wrcrooks/5U-19in-DAS-Chassis/README.md

# 5U 19-inch DAS Chassis

A 5U rack-mount direct-attached storage chassis for 48 3.5-inch drives, designed to be cooled by quiet
120 mm fans. The sheet-metal parts are laid out for laser cutting and bending by
[SendCutSend](https://sendcutsend.com/) in 0.080 in (2.032 mm) 5052-H32 aluminium; the handles and
backplane trays are 3D printed.

**Status: design in progress. Nothing here has been manufactured or thermally tested yet.** See
[Open items](#open-items) before ordering parts.

## Design summary

| | |
|---|---|
| Drives | 48 x 3.5 in, in 16 stacks of three, broad faces parallel to the airflow |
| Backplanes | 4 x Supermicro BPN-SAS3-826EL1 / BPN-SAS3-826EL1-N4 (same hole pattern), on printed trays at 105.4 mm pitch |
| SAS expanders | 2 x Adaptec AEC-82885T (36-port, 12 Gb/s) in the Back Panel card slots, external SFF-8644 to the host, powered by 4-pin Molex |
| Fans | 3 x 120 mm in the Bezel and 3 x 120 mm in the fan wall behind the drives |
| Envelope | 430 mm wide (436 mm over the cover flanges), 738 mm deep, 221 mm (5U) at the Bezel |
| Airflow | Front to back: Bezel, drive array, fan wall, rear electronics, Back Panel exhaust |
| Covers | Two drop-in lids (drive bay and rear electronics), no fasteners, finger holes for lifting |

The backplanes are spread apart rather than mounted edge to edge. That leaves 25 mm of air between drive
stacks, which keeps the pressure drop through the array low enough for quiet fans.

## Repository layout

```
CAD/
  Assembly - *.step        Original Onshape export, one part per file (reference, not edited)
  Complete-Assembly/       Original Onshape assembly
  Backplane Tray/          Printed backplane tray parts (original)
  Revised/                 Manufacturable parts and assembly, generated by tools/rebuild_parts.py
  Flat-Patterns/           DXF flat patterns, bend-data.json and Bend-Data.md
tools/
  sheetmetal.py            Unfolding, re-thickening and DXF writing
  rebuild_parts.py         Builds CAD/Revised/ from the Onshape export
  unfold_sheet_metal.py    Builds CAD/Flat-Patterns/ from CAD/Revised/
```

[`CAD/Flat-Patterns/Bend-Data.md`](CAD/Flat-Patterns/Bend-Data.md) is the main design document. It lists
every change from the Onshape export and the reason for it, the material and bend parameters, a bend
table per part, and the checks against SendCutSend's design rules.

[`BOM.md`](BOM.md) is the bill of materials with a cost estimate for one build.

## Parts

**Sheet metal** (STEP in `CAD/Revised/`, DXF in `CAD/Flat-Patterns/`):

| Part | Qty | Bends |
|---|---|---|
| Chassis | 1 | 2 |
| Bezel | 1 | 0 |
| Back Panel | 1 | 2 |
| Chassis Rear Support Bracket (fan wall) | 1 | 2 |
| Drive Support Panel | 1 | 2 |
| Bezel Mounting Bracket | 2 | 1 |
| Drive Bay Cover | 1 | 2 |
| Rear Electronics Cover | 1 | 2 |
| Attic Baffle | 2 | 2 |

**3D printed:**

| Part | Qty | Source |
|---|---|---|
| Left / Right Front Handle (ABS) | 1 each | `CAD/Assembly - * Front Handle.step` |
| Backplane Tray, Part A and Part B | 4 each | `CAD/Backplane Tray/` |
| Backplane Tray Connector (joins Part A to Part B) | 8 | `CAD/Backplane Tray/` |
| Backplane Tray Connector (Wide) (joins neighbouring trays) | 12 | `CAD/Revised/` |
| Backplane Tray Air Dam | 4 | `CAD/Revised/` |
| Card Edge Support | 1 | `CAD/Revised/` |

The SFF8643 to M.2 Mounting Bracket is exported as designed in Onshape; how it will be made is undecided.

## Regenerating the outputs

Requires [FreeCAD](https://www.freecad.org/) 0.20 or later (developed against 0.20.2). No other
dependencies. From the repository root:

```sh
freecadcmd tools/rebuild_parts.py       # CAD/*.step -> CAD/Revised/
freecadcmd tools/unfold_sheet_metal.py  # CAD/Revised/ -> CAD/Flat-Patterns/
```

Run both, in that order, after any change. Dimensions of the new and modified parts are constants at
the top of `tools/rebuild_parts.py`; material and bend parameters are in `MATERIAL` in
`tools/sheetmetal.py`. Both scripts check their own results (valid solids, closed contours, cut-out
counts, interference between parts) and print the findings.

## DXF conventions

Millimetres at 1:1, everything on layer `0`. Cut geometry is continuous; bend centrelines are `DASHED`.
Each pattern is drawn looking at the face the flanges fold toward, so every bend is 90° up.

## Open items

- **Thermal performance is estimated by hand, not simulated or measured.** Test one fully populated
  backplane with the intended fans before committing to the full build.
- **Fan-wall cable cut-outs** are larger than the cables need and let air recirculate. They need to be
  sized to the real cable bundles or closed with brush strip or foam.
- **Drive position on the backplane** is taken from the tray model, not measured on a real board. Check
  the Drive Support Panel openings against a populated backplane before cutting.
- **Card Edge Support position is estimated.** The sideways position of the card PCBs is worked out from
  the Back Panel openings, not measured on a card. The support's slotted holes give ±4 mm; check the fit
  with a card in hand before drilling or ordering the Chassis.
- **Empty drive positions** need printed blanks, or air will bypass the populated ones.
- **Dust:** fit screw-on filters to the Bezel fan positions. The Bezel is aluminium, so magnetic filters
  will not hold.
- **Covers are held by gravity only** and need securing for transport.
- The Back Panel has one 1.35 mm strip between cut-outs, carried over from the original model.

## License

[CC0 1.0 Universal](LICENSE). The design files, flat patterns, scripts and documentation are dedicated to
the public domain: anyone may copy, modify, manufacture, sell and redistribute them for any purpose,
without asking permission or giving credit. They are provided as-is, with no warranty.
