wrcrooks/5U-19in-DAS-Chassis/CAD/Assembly - SFF8643 to M.2 Mounting Bracket.step

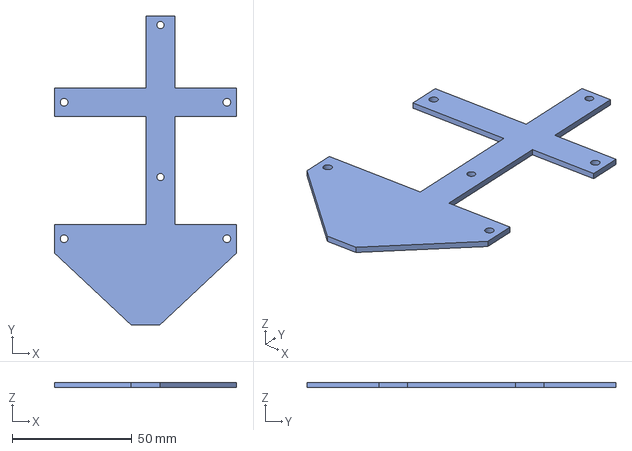
[picture p1: CAD file, 2026-11-12]
CAD/Assembly - SFF8643 to M.2 Mounting Bracket.step
76.0 x 129.0 x 2.00 mm
