wrcrooks/5U-19in-DAS-Chassis/CAD/Complete-Assembly/Complete-Assembly.step

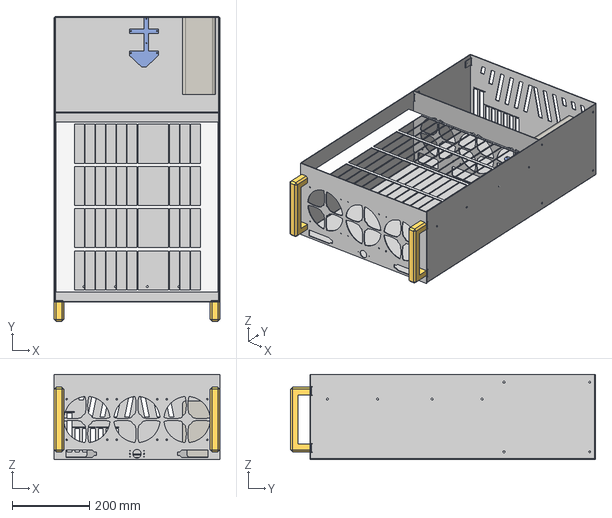
[picture p2: CAD file, 2026-11-12]
CAD/Complete-Assembly/Complete-Assembly.step
430.0 x 792.0 x 221.0 mm
