wrcrooks/5U-19in-DAS-Chassis/CAD/Assembly - Drive Support Panel.step

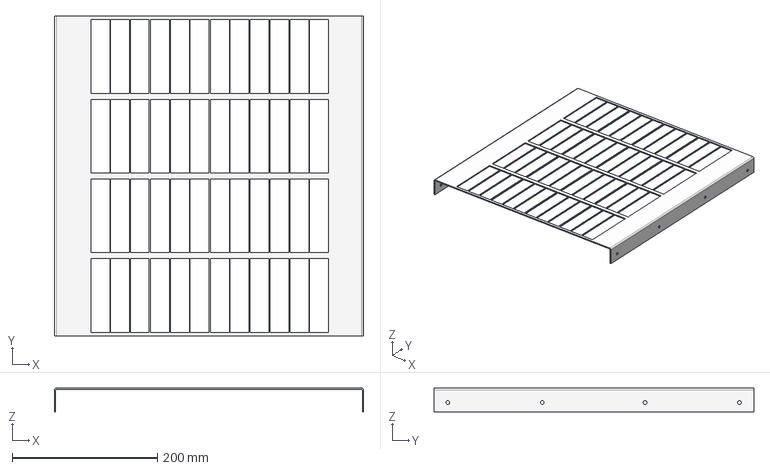
[picture p3: CAD file, 2026-11-12]
CAD/Assembly - Drive Support Panel.step
426.0 x 440.5 x 33.0 mm
