wrcrooks/5U-19in-DAS-Chassis/CAD/Revised/Complete-Assembly.step

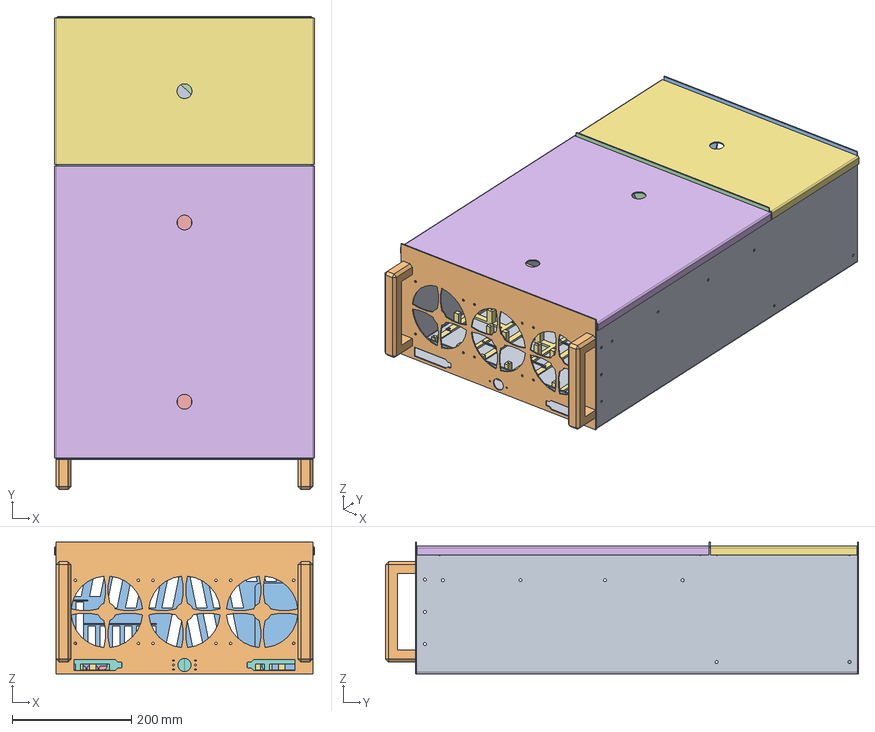
[picture p4: CAD file, 2026-11-13]
CAD/Revised/Complete-Assembly.step
436.1 x 792.1 x 221.0 mm
Chassis
Bezel
Back Panel
Chassis Rear Support Bracket
Drive Support Panel
Drive Bay Cover
Rear Electronics Cover
Attic Baffle (Front)
Attic Baffle (Rear)
Bezel Mounting Bracket (Right)
Bezel Mounting Bracket (Left)
Left Front Handle
Right Front Handle
PSU
SFF8643 to M.2 Mounting Bracket
Card Edge Support
Backplane Tray 1 Part A
Backplane Tray 1 Part B
Air Dam 1
Backplane Tray 2 Part A
Backplane Tray 2 Part B
Air Dam 2
Backplane Tray 3 Part A
Backplane Tray 3 Part B
Air Dam 3
Backplane Tray 4 Part A
Backplane Tray 4 Part B
Air Dam 4
Tray 1 Connector
Tray 1 Connector001
Tray 1-2 Connector (Wide)
Tray 1-2 Connector (Wide)001
Tray 1-2 Connector (Wide)002
Tray 1-2 Connector (Wide)003
Tray 2 Connector
Tray 2 Connector001
Tray 2-3 Connector (Wide)
Tray 2-3 Connector (Wide)001
Tray 2-3 Connector (Wide)002
Tray 2-3 Connector (Wide)003
Tray 3 Connector
Tray 3 Connector001
Tray 3-4 Connector (Wide)
Tray 3-4 Connector (Wide)001
Tray 3-4 Connector (Wide)002
Tray 3-4 Connector (Wide)003
Tray 4 Connector
Tray 4 Connector001
