wrcrooks/5U-19in-DAS-Chassis/CAD/Assembly - PSU.step

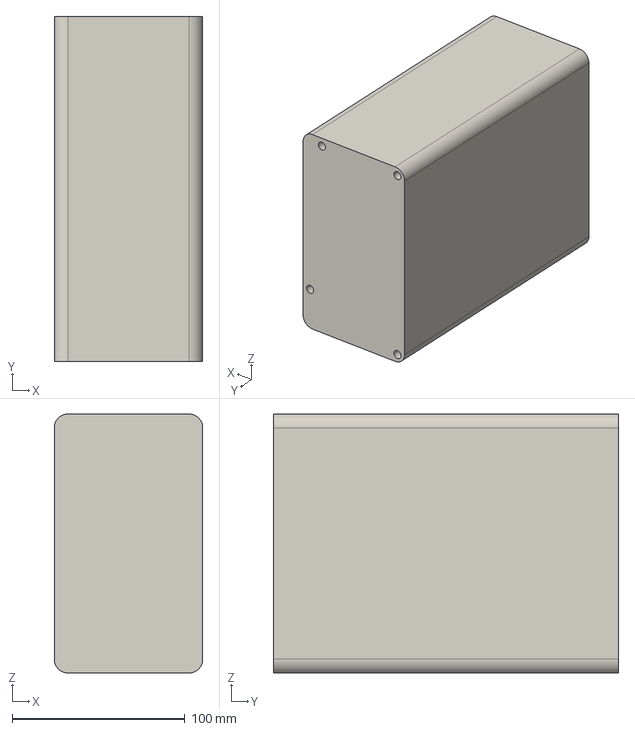
[picture p5: CAD file, 2026-11-12]
CAD/Assembly - PSU.step
86.0 x 200.0 x 150.0 mm
