wrcrooks/5U-19in-DAS-Chassis/CAD/Assembly - Right Front Handle.step

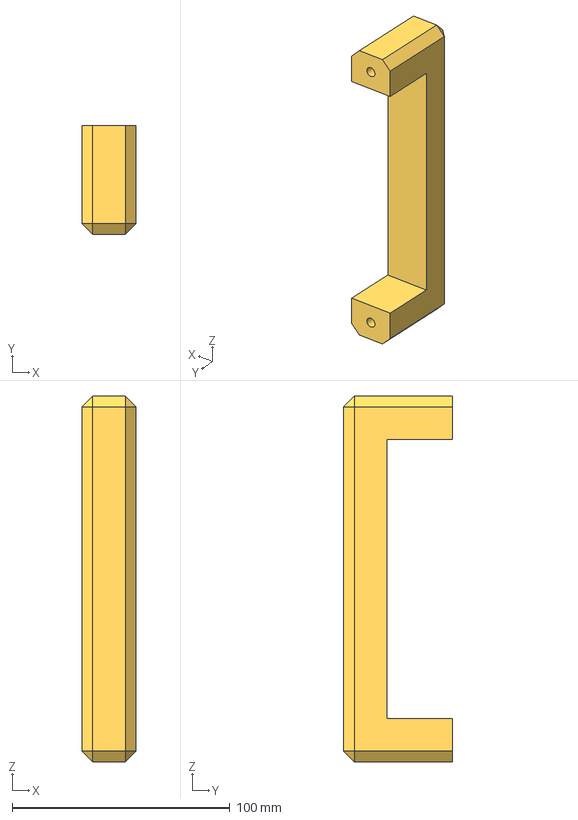
[picture p6: CAD file, 2026-11-12]
CAD/Assembly - Right Front Handle.step
25.0 x 50.0 x 168.0 mm
