wrcrooks/5U-19in-DAS-Chassis/CAD/Assembly - Bezel.step

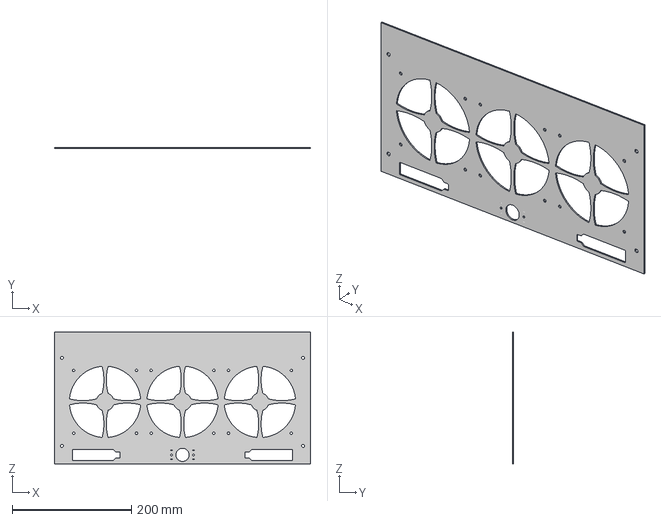
[picture p7: CAD file, 2026-11-12]
CAD/Assembly - Bezel.step
430.0 x 2.00 x 221.0 mm
