wrcrooks/5U-19in-DAS-Chassis/CAD/Assembly - Chassis Rear Support Bracket.step

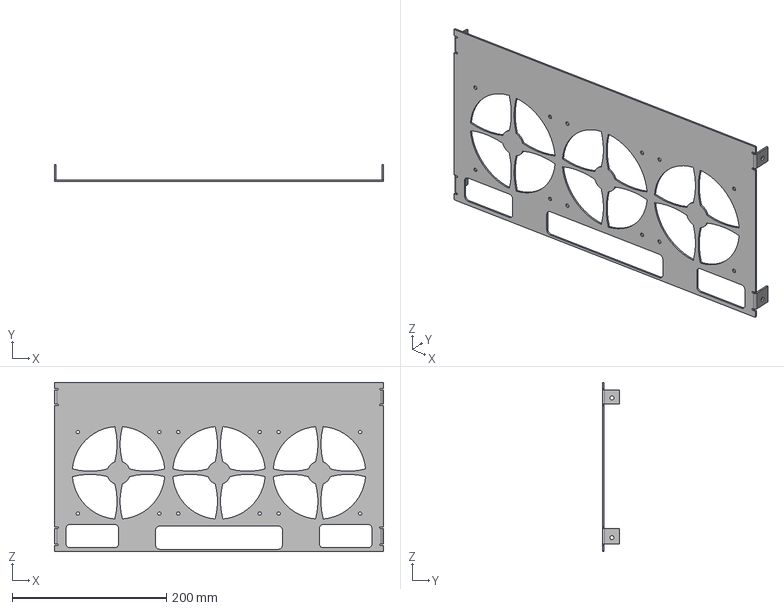
[picture p8: CAD file, 2026-11-12]
CAD/Assembly - Chassis Rear Support Bracket.step
426.0 x 22.5 x 219.0 mm
