wrcrooks/5U-19in-DAS-Chassis/CAD/Assembly - Back Panel.step

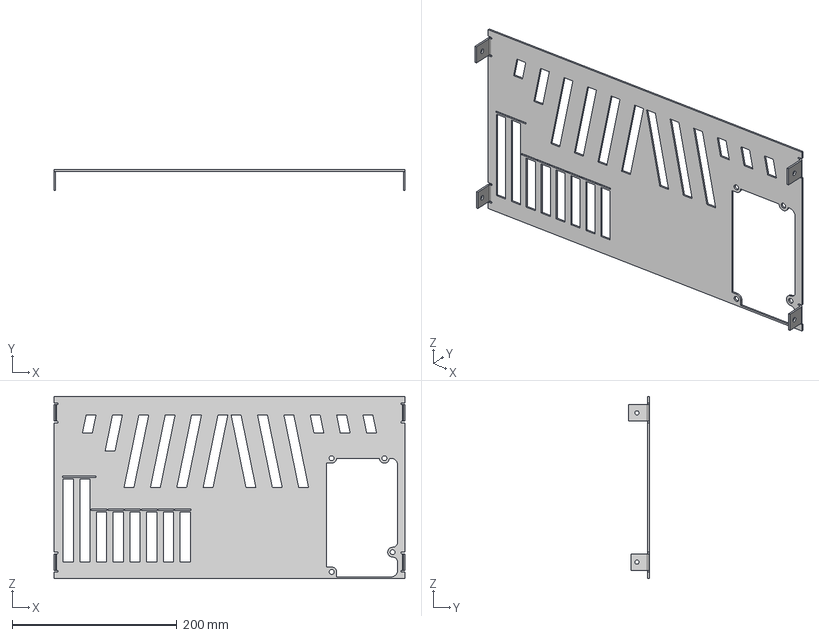
[picture p9: CAD file, 2026-11-12]
CAD/Assembly - Back Panel.step
426.0 x 25.0 x 221.0 mm
