wrcrooks/5U-19in-DAS-Chassis/CAD/Assembly - Chassis.step

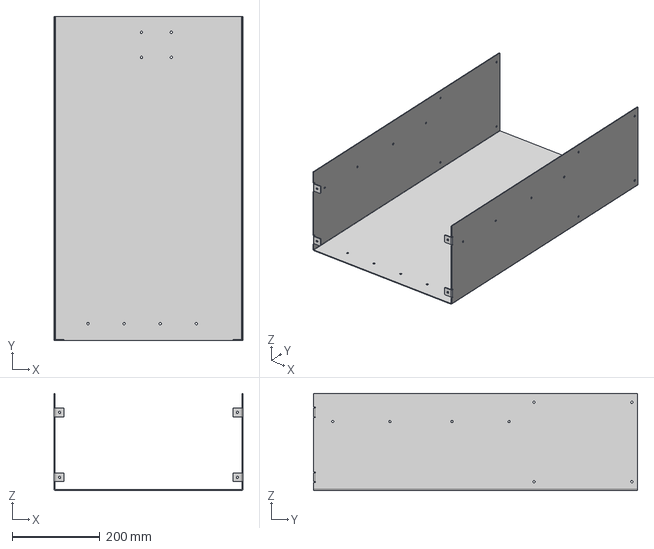
[picture p10: CAD file, 2026-11-12]
CAD/Assembly - Chassis.step
430.0 x 738.0 x 221.0 mm
