wrcrooks/5U-19in-DAS-Chassis/CAD/Backplane Tray/Backplane Tray - Part B.step

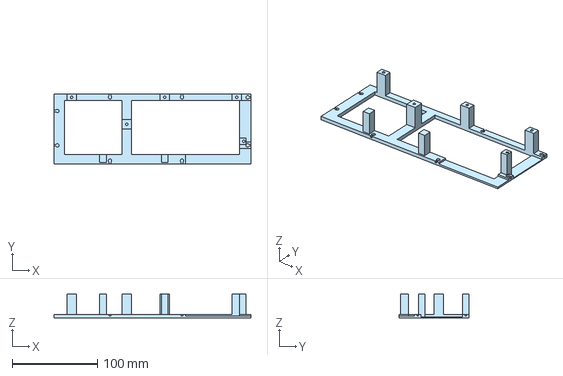
[picture p11: CAD file, 2026-11-12]
CAD/Backplane Tray/Backplane Tray - Part B.step
231.0 x 82.3 x 28.0 mm
