wrcrooks/5U-19in-DAS-Chassis/CAD/Flat-Patterns/Chassis.dxf

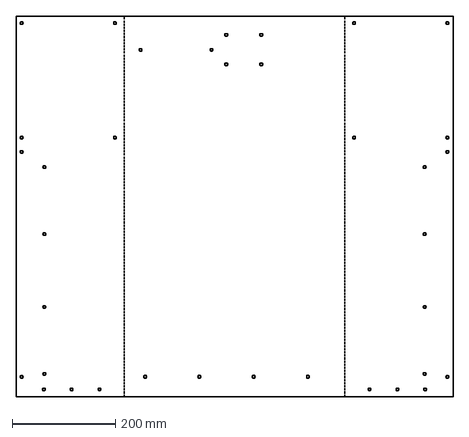
[picture p12: CAD file, 2026-11-13]
CAD/Flat-Patterns/Chassis.dxf
848.2 x 738.0 mm
