wrcrooks/5U-19in-DAS-Chassis/CAD/Revised/Card Edge Support.step

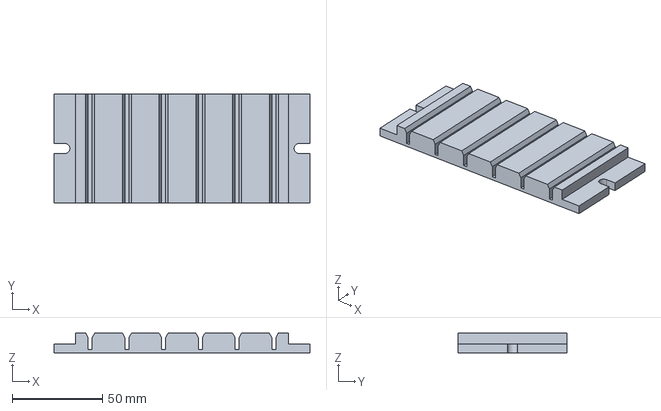
[picture p13: CAD file, 2026-11-13]
CAD/Revised/Card Edge Support.step
141.5 x 60.0 x 11.0 mm
