wrcrooks/5U-19in-DAS-Chassis/CAD/Backplane Tray/Backplane Tray - Part A.step

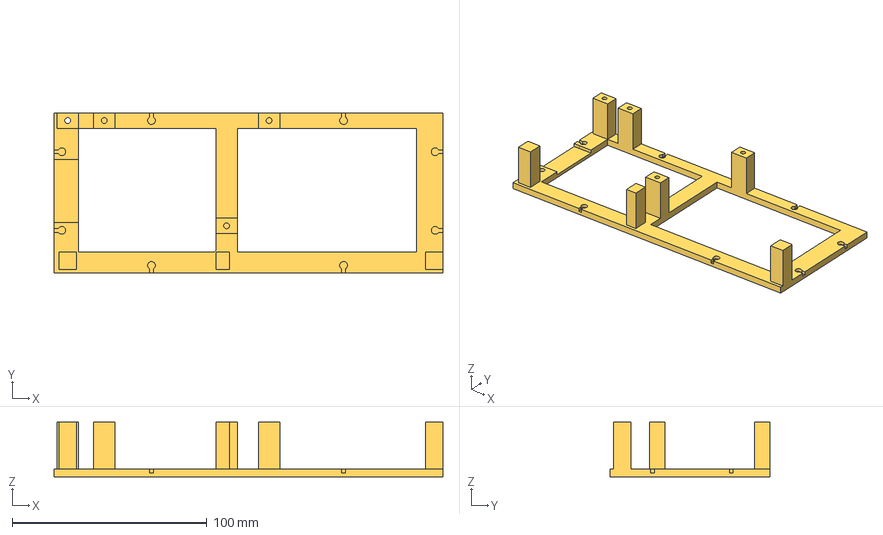
[picture p14: CAD file, 2026-11-12]
CAD/Backplane Tray/Backplane Tray - Part A.step
199.5 x 82.3 x 28.0 mm
