wrcrooks/5U-19in-DAS-Chassis/CAD/Flat-Patterns/Rear Electronics Cover.dxf

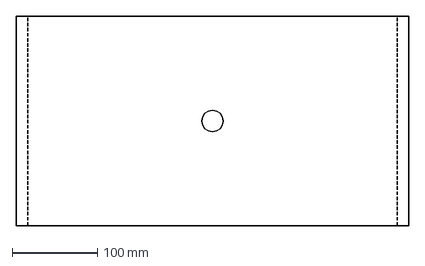
[picture p15: CAD file, 2026-11-12]
CAD/Flat-Patterns/Rear Electronics Cover.dxf
460.2 x 245.5 mm
