wrcrooks/5U-19in-DAS-Chassis/CAD/Backplane Tray/Backplane Tray - Connector.step

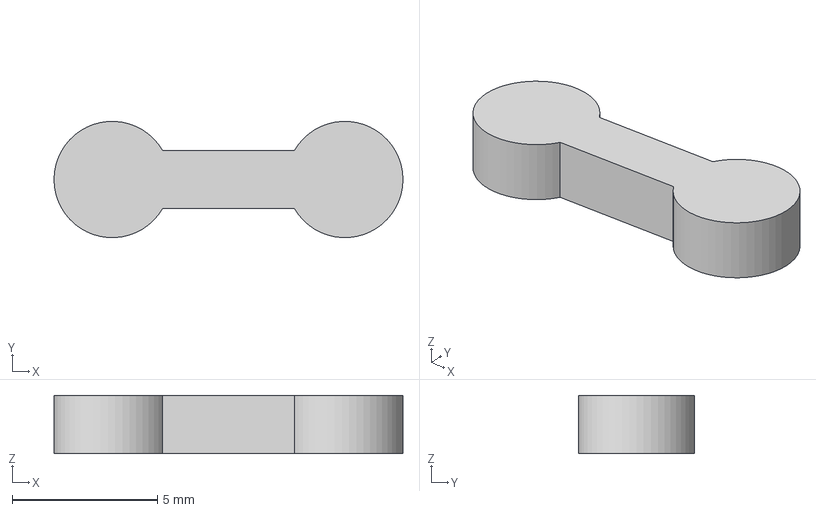
[picture p16: CAD file, 2026-11-12]
CAD/Backplane Tray/Backplane Tray - Connector.step
12.0 x 4.00 x 2.00 mm
