wrcrooks/5U-19in-DAS-Chassis/CAD/Flat-Patterns/Bezel.dxf

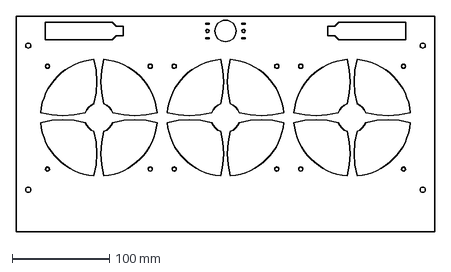
[picture p17: CAD file, 2026-11-12]
CAD/Flat-Patterns/Bezel.dxf
430.0 x 221.0 mm
