wrcrooks/5U-19in-DAS-Chassis/CAD/Revised/Chassis.step

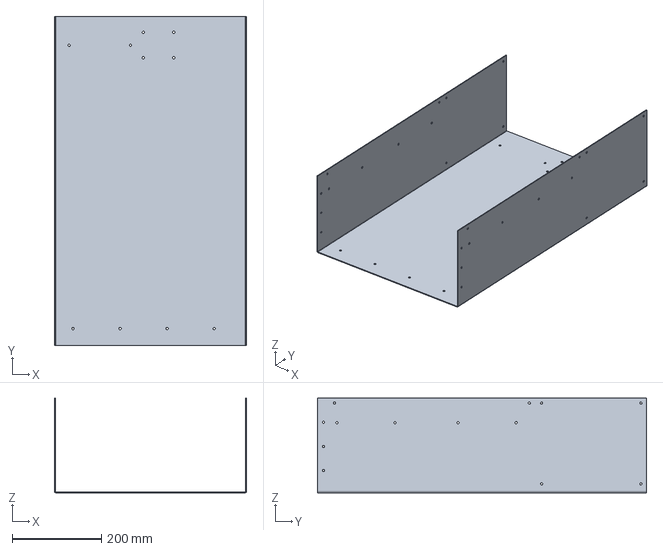
[picture p18: CAD file, 2026-11-13]
CAD/Revised/Chassis.step
430.1 x 738.0 x 212.0 mm
