wrcrooks/5U-19in-DAS-Chassis/CAD/Flat-Patterns/Bezel Mounting Bracket.dxf

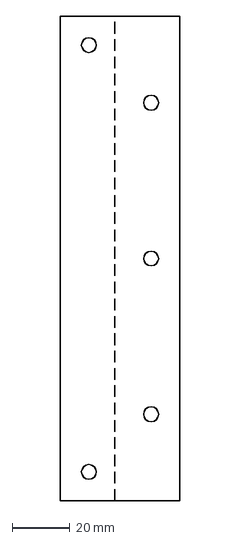
[picture p19: CAD file, 2026-11-12]
CAD/Flat-Patterns/Bezel Mounting Bracket.dxf
41.6 x 168.0 mm
