wrcrooks/5U-19in-DAS-Chassis/CAD/Revised/Backplane Tray - Connector (Wide).step

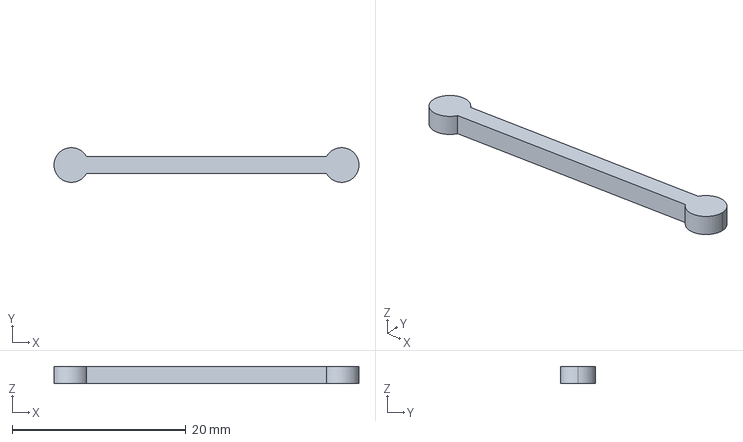
[picture p20: CAD file, 2026-11-13]
CAD/Revised/Backplane Tray - Connector (Wide).step
35.1 x 4.00 x 2.00 mm
