wrcrooks/5U-19in-DAS-Chassis/CAD/Flat-Patterns/Drive Support Panel.dxf

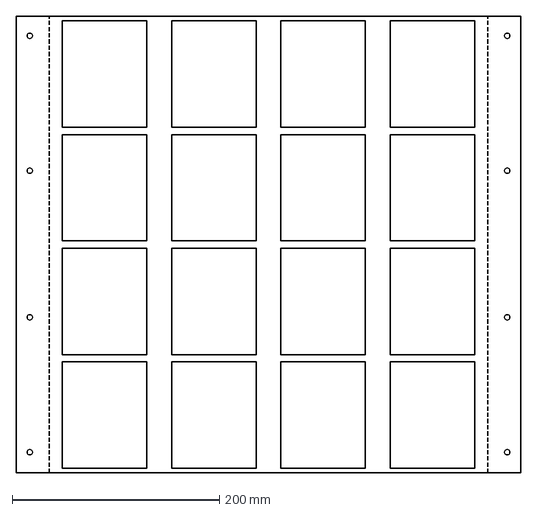
[picture p21: CAD file, 2026-11-12]
CAD/Flat-Patterns/Drive Support Panel.dxf
486.2 x 440.5 mm
