wrcrooks/5U-19in-DAS-Chassis/CAD/Revised/Back Panel.step

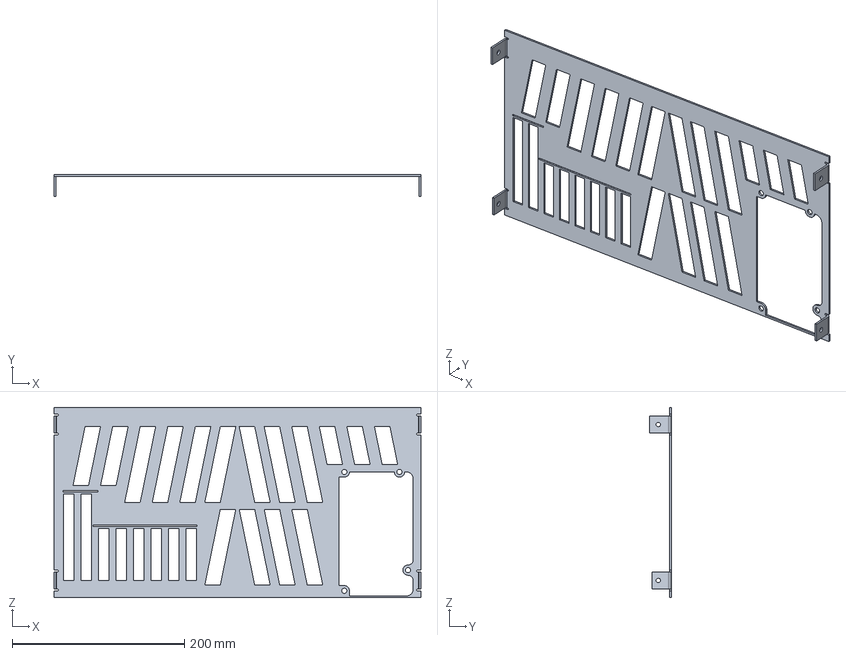
[picture p22: CAD file, 2026-11-12]
CAD/Revised/Back Panel.step
426.1 x 25.0 x 221.0 mm
