wrcrooks/5U-19in-DAS-Chassis/CAD/Flat-Patterns/Drive Bay Cover.dxf

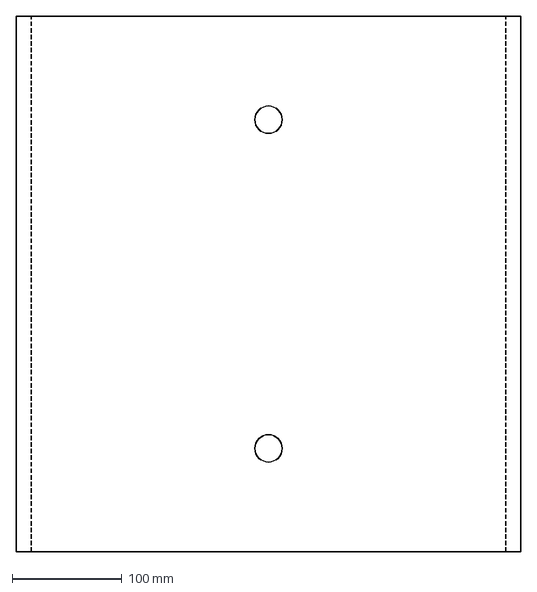
[picture p23: CAD file, 2026-11-12]
CAD/Flat-Patterns/Drive Bay Cover.dxf
460.2 x 488.9 mm
