wrcrooks/5U-19in-DAS-Chassis/CAD/Revised/Rear Electronics Cover.step

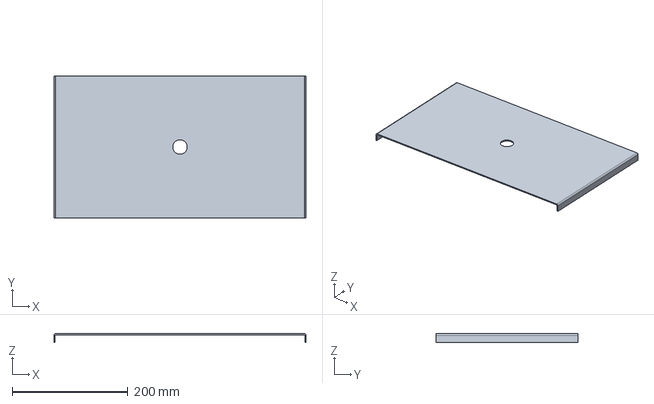
[picture p24: CAD file, 2026-11-12]
CAD/Revised/Rear Electronics Cover.step
436.1 x 245.5 x 15.0 mm
