wrcrooks/5U-19in-DAS-Chassis/CAD/Flat-Patterns/Back Panel.dxf

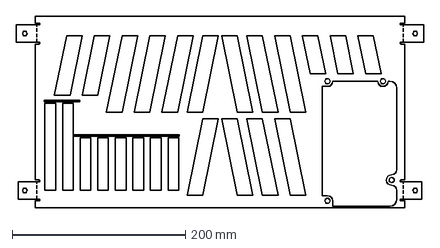
[picture p25: CAD file, 2026-11-12]
CAD/Flat-Patterns/Back Panel.dxf
470.2 x 221.0 mm
