wrcrooks/5U-19in-DAS-Chassis/CAD/Revised/Bezel Mounting Bracket.step

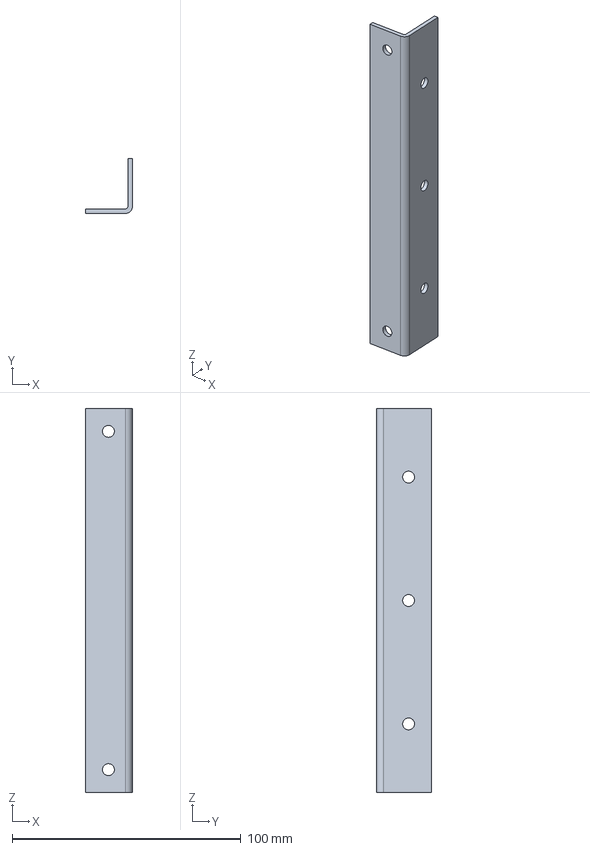
[picture p26: CAD file, 2026-11-12]
CAD/Revised/Bezel Mounting Bracket.step
20.5 x 24.0 x 168.0 mm
