wrcrooks/5U-19in-DAS-Chassis/CAD/Flat-Patterns/Attic Baffle.dxf

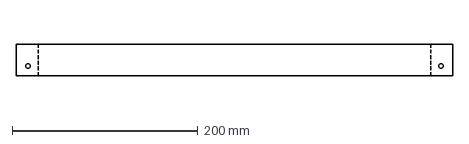
[picture p27: CAD file, 2026-11-12]
CAD/Flat-Patterns/Attic Baffle.dxf
469.6 x 34.0 mm
