wrcrooks/5U-19in-DAS-Chassis/CAD/Revised/Bezel.step

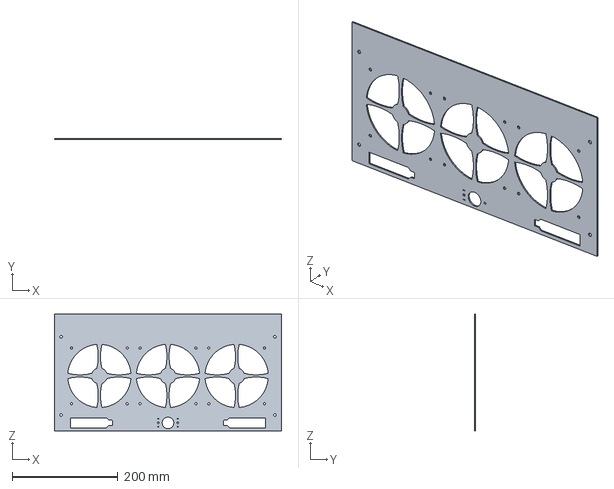
[picture p28: CAD file, 2026-11-12]
CAD/Revised/Bezel.step
430.0 x 2.03 x 221.0 mm
