wrcrooks/5U-19in-DAS-Chassis/CAD/Flat-Patterns/Chassis Rear Support Bracket.dxf

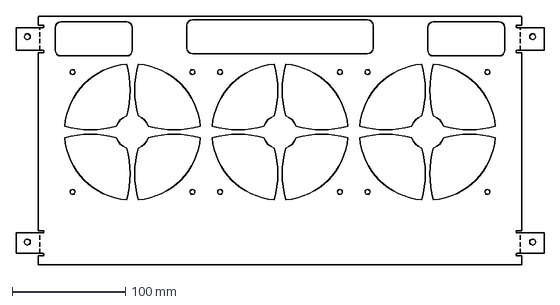
[picture p29: CAD file, 2026-11-12]
CAD/Flat-Patterns/Chassis Rear Support Bracket.dxf
465.2 x 219.0 mm
