wrcrooks/5U-19in-DAS-Chassis/CAD/Revised/Attic Baffle.step

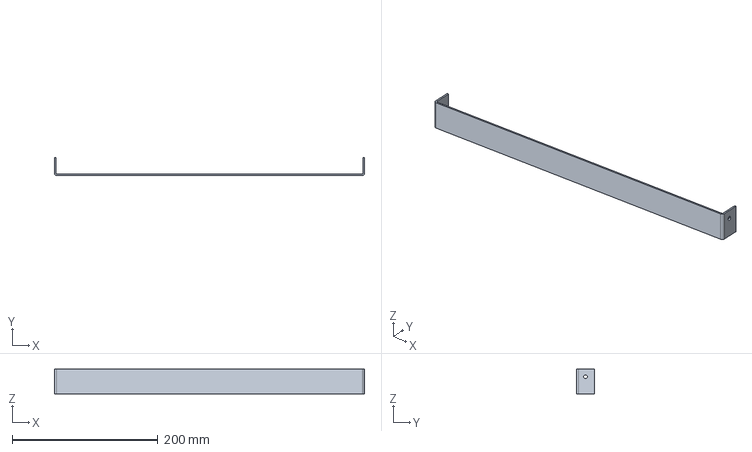
[picture p30: CAD file, 2026-11-12]
CAD/Revised/Attic Baffle.step
425.5 x 25.0 x 34.0 mm
