wrcrooks/5U-19in-DAS-Chassis/CAD/Revised/Chassis Rear Support Bracket.step

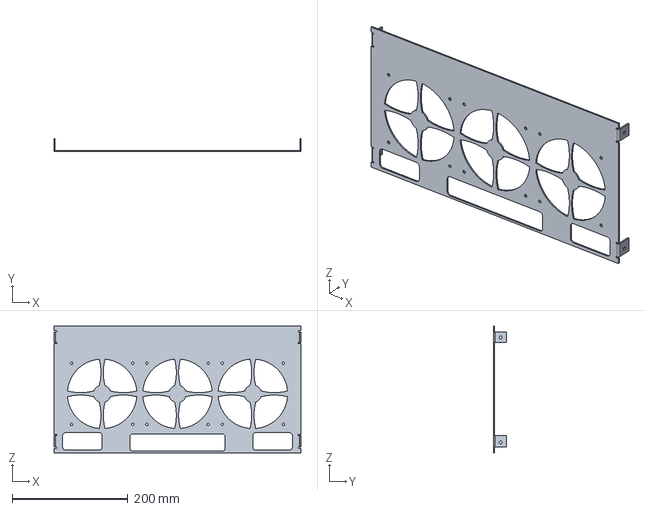
[picture p31: CAD file, 2026-11-12]
CAD/Revised/Chassis Rear Support Bracket.step
426.1 x 22.5 x 219.0 mm
