wrcrooks/5U-19in-DAS-Chassis/CAD/Revised/Backplane Tray - Air Dam.step

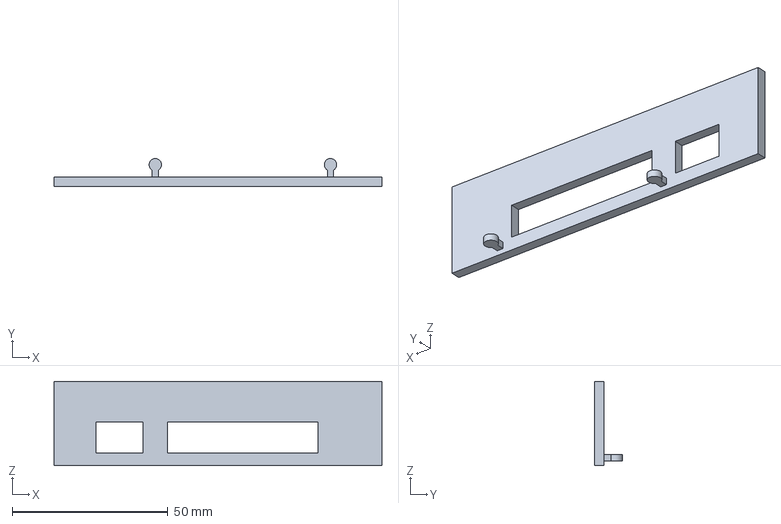
[picture p32: CAD file, 2026-11-12]
CAD/Revised/Backplane Tray - Air Dam.step
105.4 x 9.00 x 27.0 mm
