wrcrooks/5U-19in-DAS-Chassis/CAD/Revised/Drive Support Panel.step

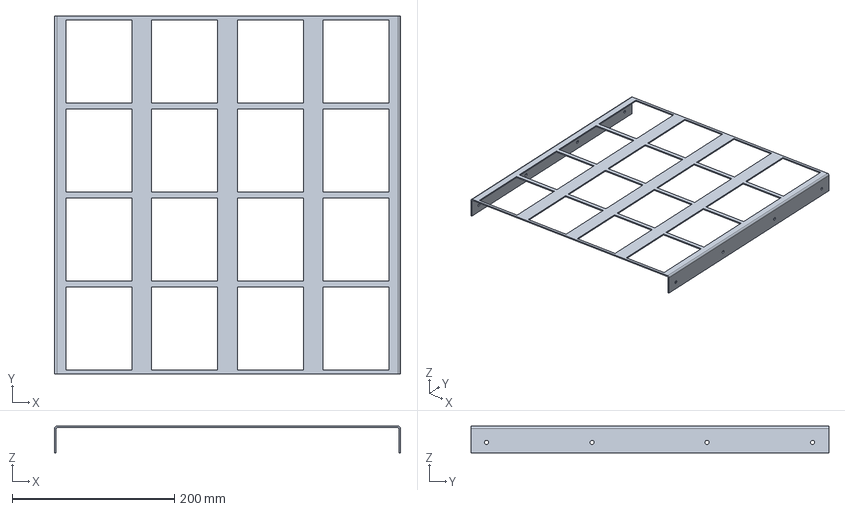
[picture p33: CAD file, 2026-11-12]
CAD/Revised/Drive Support Panel.step
426.1 x 440.5 x 33.0 mm
