wrcrooks/5U-19in-DAS-Chassis/CAD/Revised/Drive Bay Cover.step

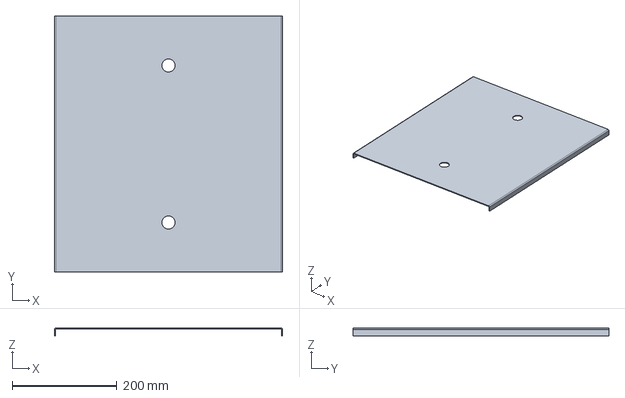
[picture p34: CAD file, 2026-11-12]
CAD/Revised/Drive Bay Cover.step
436.1 x 488.9 x 15.0 mm
