wrcrooks/5U-19in-DAS-Chassis/(list of files, cad)

Other CAD files:
CAD/Assembly - Left Front Handle.step
