wrcrooks/5U-19in-DAS-Chassis/(commit log)

2026-11-12 Initial commit: 5U 19-inch 48-drive DAS chassis
    Onshape STEP export, revised manufacturable sheet-metal parts, DXF flat
    patterns with bend data for SendCutSend, and the FreeCAD scripts that
    generate them.
    Claude-Session: https://claude.ai/code/session_01EHXMQ2gWrtN7CUzKrmNxae
    [Assembly - Back Panel.step, Assembly - Bezel.step, Assembly - Chassis Rear Support Bracket.step, Assembly - Chassis.step, Assembly - Drive Support Panel.step, Assembly - Left Front Handle.step, Assembly - PSU.step, Assembly - Right Front Handle.step]
2026-11-13 Add printed Card Edge Support, SAS expanders and BOM
    - Card Edge Support: printed comb screwed to the Chassis floor that holds
    the edge connectors of the Adaptec AEC-82885T expander cards
    - Two new floor holes in the Chassis for it; flat pattern regenerated
    - BOM.md with a cost estimate for one build
    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
    [Backplane Tray - Connector (Wide).step, Card Edge Support.step, Chassis.dxf, Chassis.step, Complete-Assembly.step]
